prokuranepal/vtol/README.md

# VTOL
<a href="https://prokuranepal.github.io/vtol"> Docs Link</a>
