prokuranepal/vtol/docs/html/_images/3dprinted.png

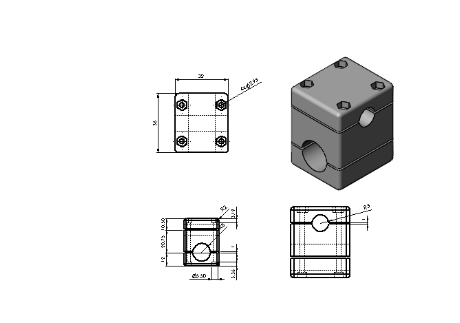
docs/html/_images/3dprinted.png
