prokuranepal/vtol/docs/html/_images/analysis2.png

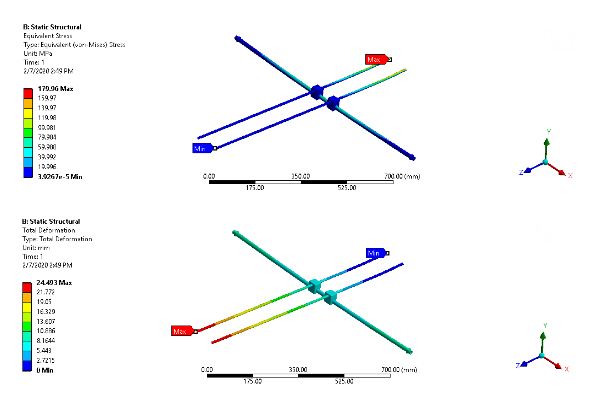
docs/html/_images/analysis2.png
