prokuranepal/vtol/docs/html/_images/flowchart.png

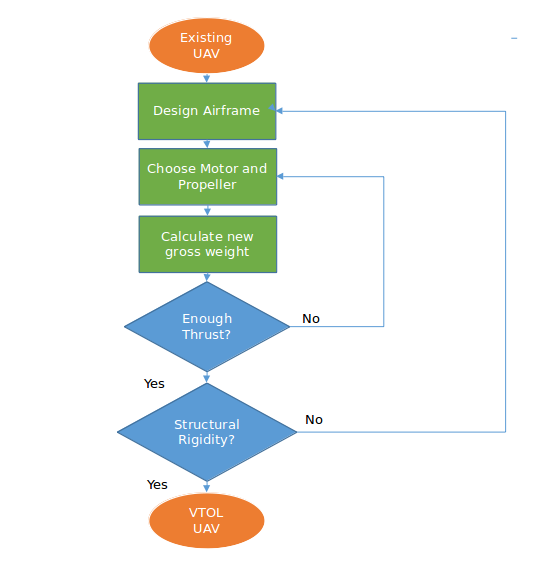
docs/html/_images/flowchart.png
