prokuranepal/vtol/docs/html/_images/graph.png

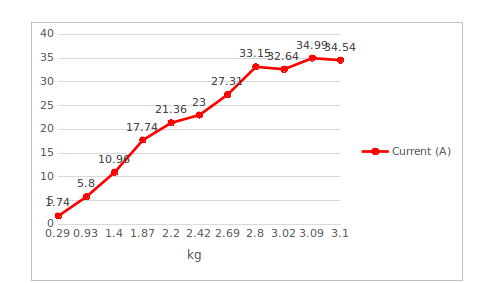
docs/html/_images/graph.png
