prokuranepal/vtol/docs/html/_images/vtol_image.png

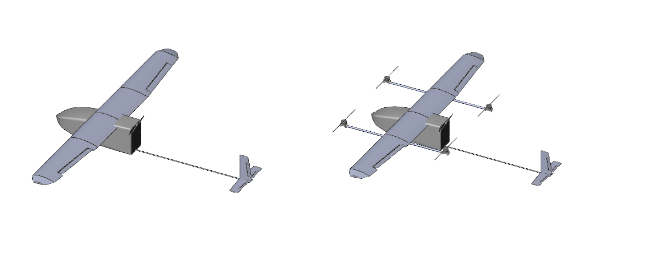
docs/html/_images/vtol_image.png
