prokuranepal/vtol/version2.SLDASM

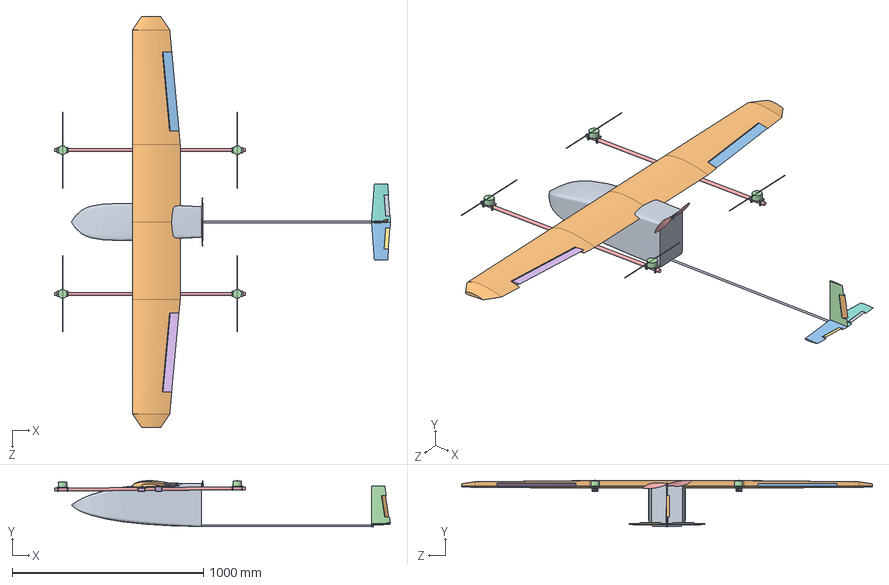
[picture p12: CAD file, 2020-02-07]
version2.SLDASM
1758.7 x 243.7 x 2150.0 mm
fuselage with boom
wing
horizontal tail
vertical tail
10x4.7-counterclockwise-propeller
aileron Port side
elevator port side
Mirrorhorizontal tail
Mirrorhorizontal tail - Copy
rudder
ailron s
boom anchor 2 x 4
quad boom x 2
anchor_wing x 4
