prokuranepal/vtol/boom anchor 2.SLDPRT

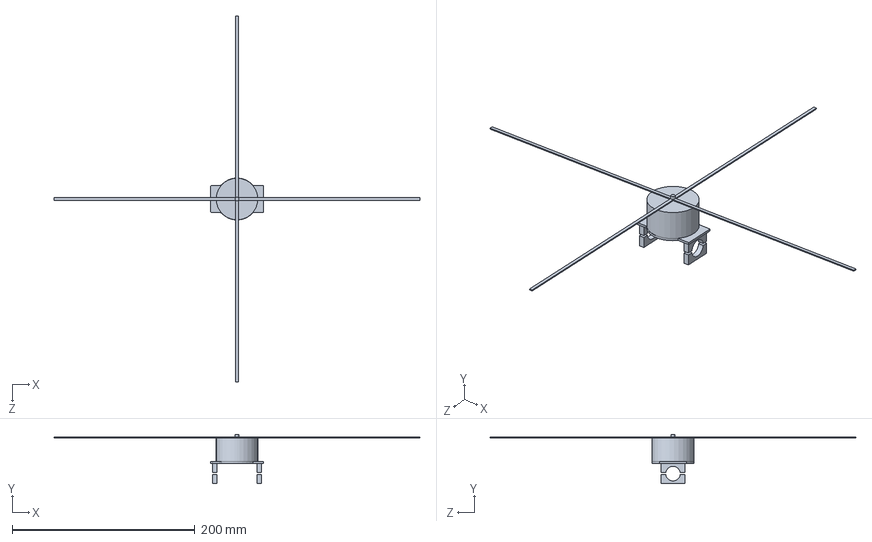
[picture p13: CAD file, 2020-02-07]
boom anchor 2.SLDPRT
400.0 x 54.0 x 400.0 mm
