prokuranepal/vtol/elevator port side.SLDPRT

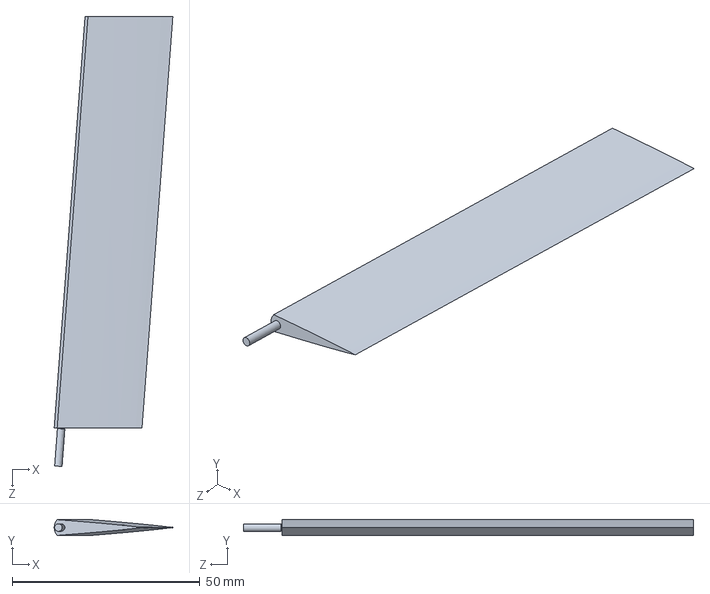
[picture p14: CAD file, 2020-02-07]
elevator port side.SLDPRT
31.7 x 4.34 x 119.9 mm
