prokuranepal/vtol/10x4.7-counterclockwise-propeller.SLDPRT

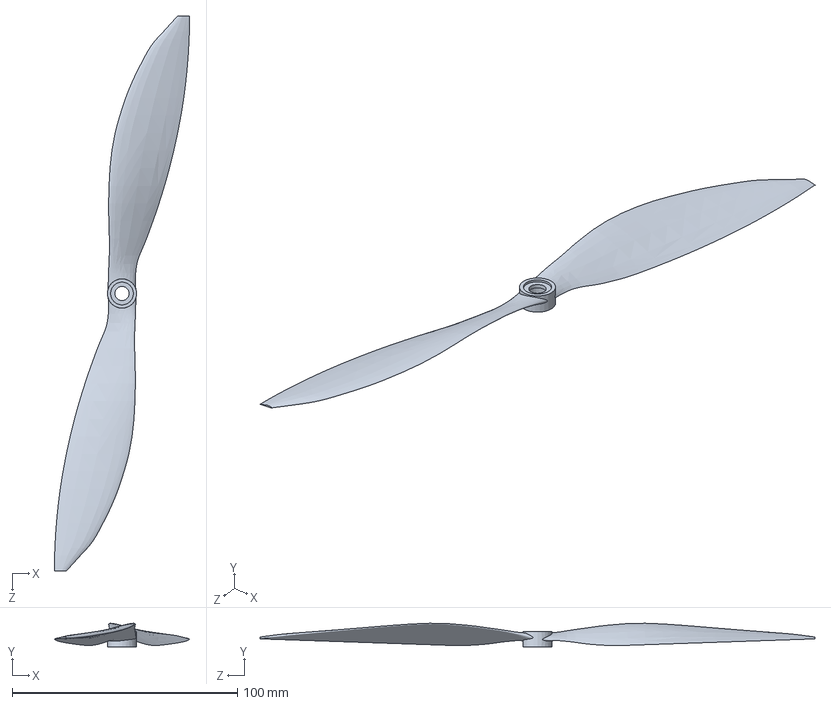
[picture p15: CAD file, 2020-02-07]
10x4.7-counterclockwise-propeller.SLDPRT
60.0 x 10.5 x 246.4 mm
