prokuranepal/vtol/horizontal tail.SLDPRT

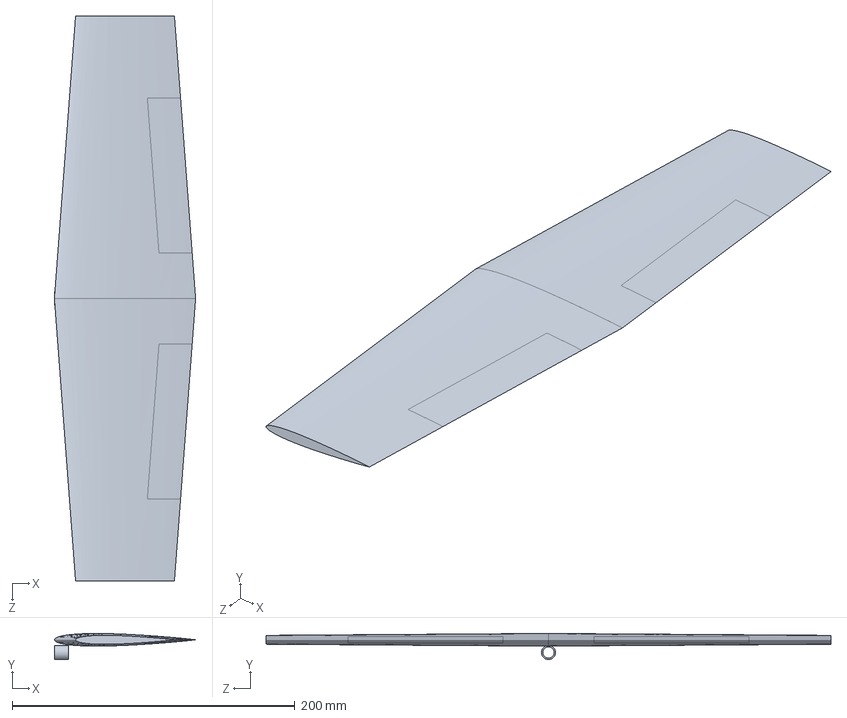
[picture p16: CAD file, 2020-02-07]
horizontal tail.SLDPRT
100.0 x 18.5 x 400.0 mm
