prokuranepal/vtol/aileron Port side.SLDPRT

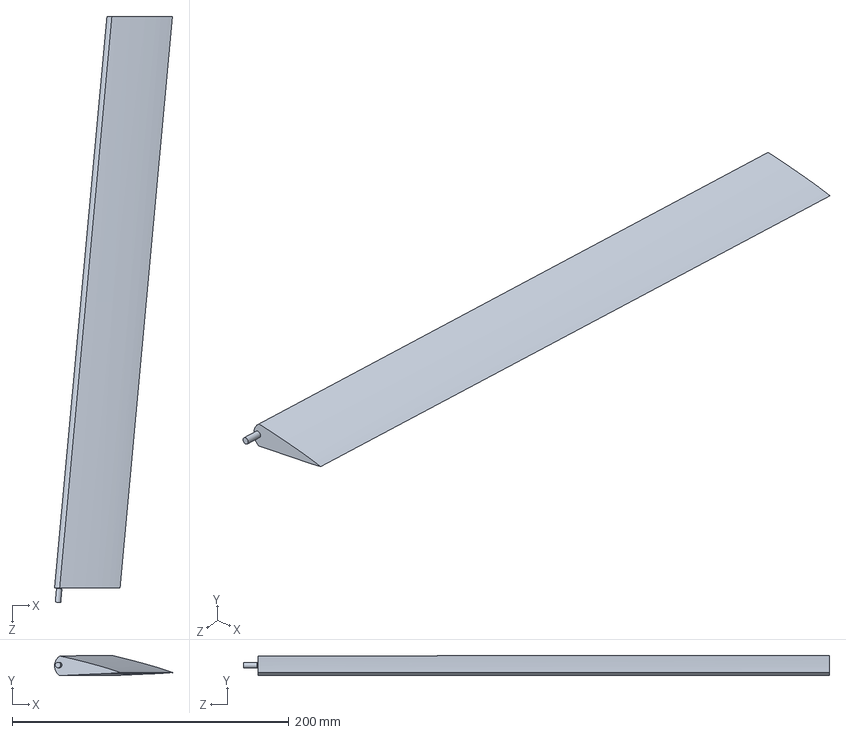
[picture p17: CAD file, 2020-02-07]
aileron Port side.SLDPRT
85.3 x 14.7 x 424.0 mm
