prokuranepal/vtol/wing.SLDPRT

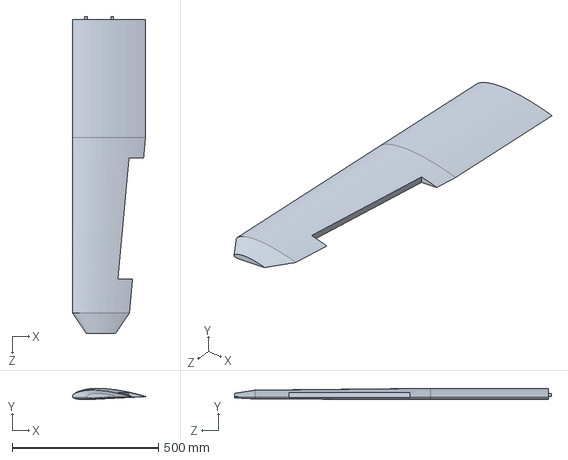
[picture p18: CAD file, 2020-02-07]
wing.SLDPRT
250.0 x 38.8 x 1085.0 mm
