prokuranepal/vtol/vertical tail.SLDPRT

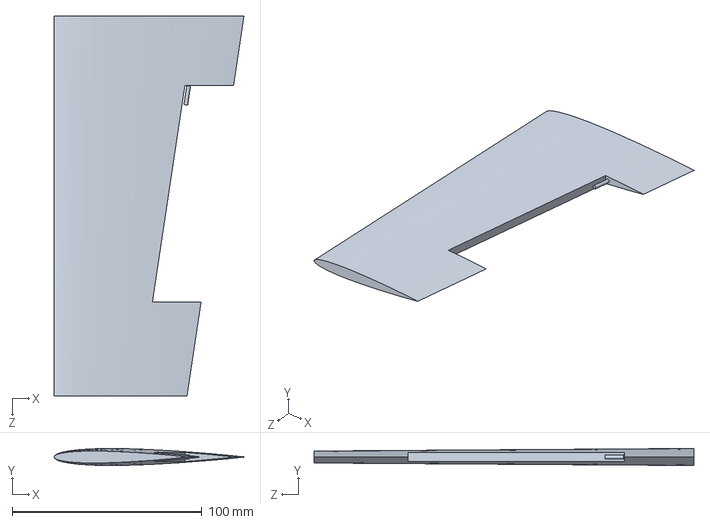
[picture p19: CAD file, 2020-02-07]
vertical tail.SLDPRT
100.0 x 9.01 x 200.0 mm
