prokuranepal/vtol/rudder.SLDPRT

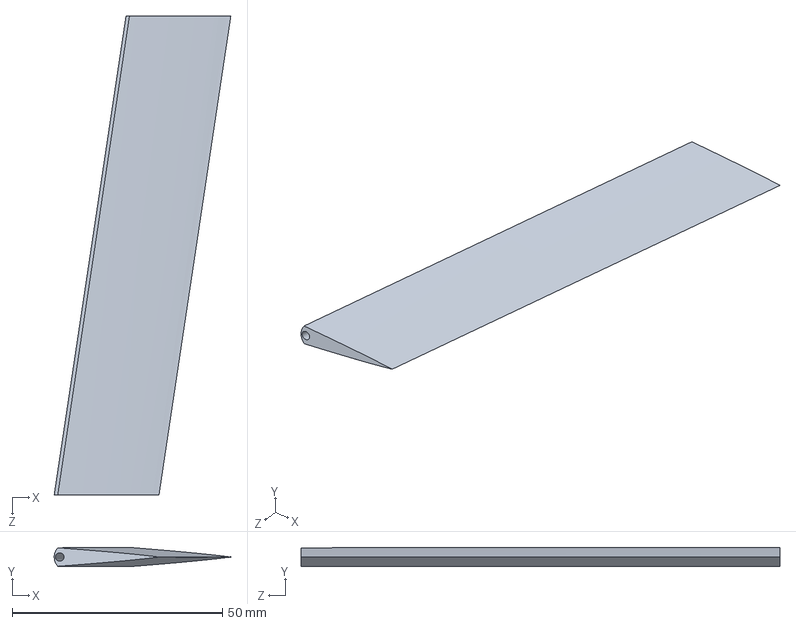
[picture p20: CAD file, 2020-02-07]
rudder.SLDPRT
42.0 x 4.56 x 113.9 mm
