prokuranepal/vtol/quad boom.SLDPRT

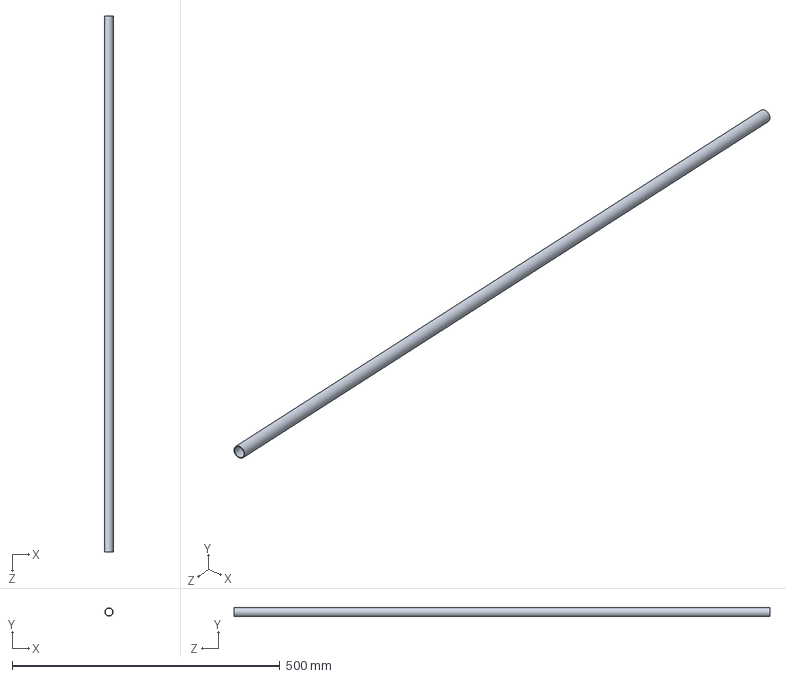
[picture p21: CAD file, 2020-02-07]
quad boom.SLDPRT
15.9 x 15.9 x 1000.0 mm
