prokuranepal/vtol/fuselage with boom.SLDPRT

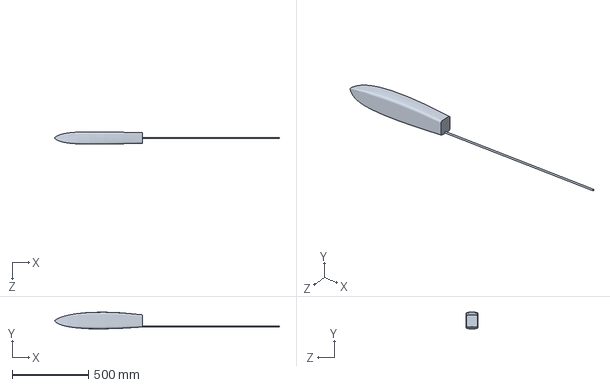
[picture p22: CAD file, 2020-02-07]
fuselage with boom.SLDPRT
1480.0 x 110.6 x 82.0 mm
