prokuranepal/vtol/ailron s.SLDPRT

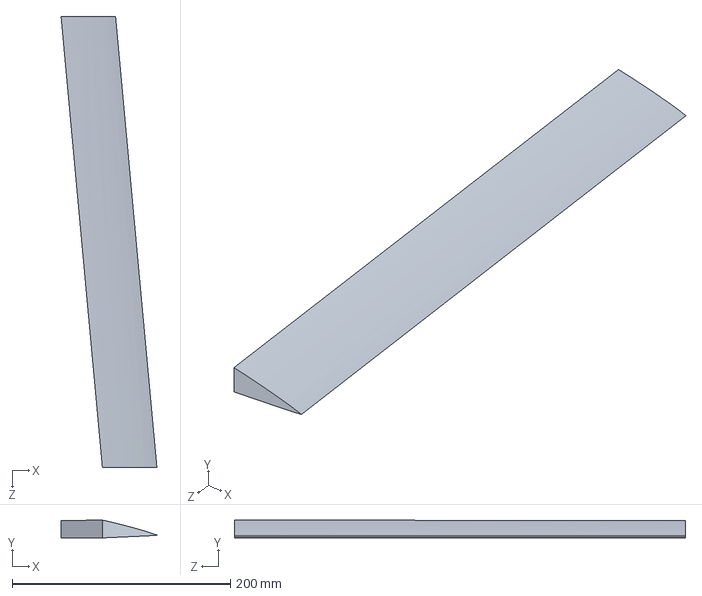
[picture p23: CAD file, 2020-02-07]
ailron s.SLDPRT
87.9 x 16.4 x 413.3 mm
