prokuranepal/vtol/anchor_wing.SLDPRT

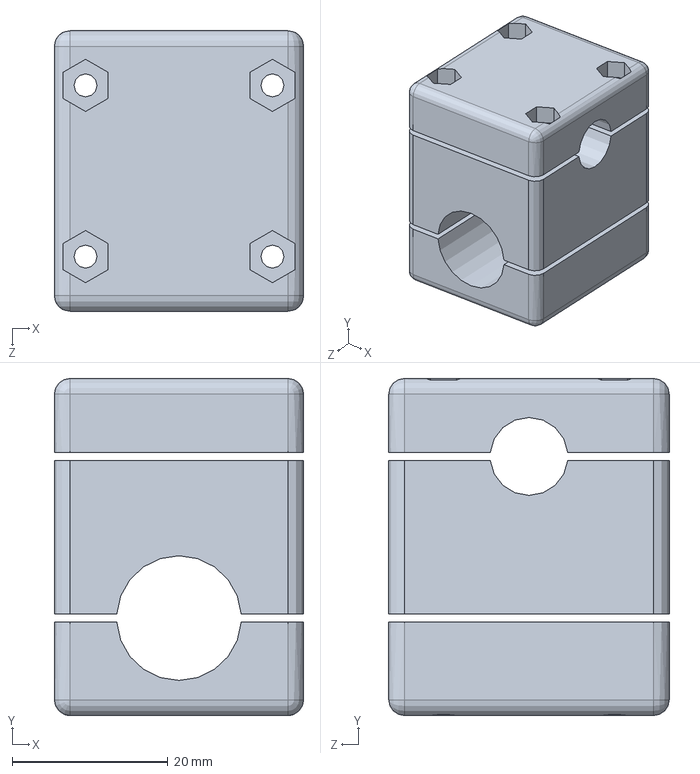
[picture p24: CAD file, 2020-02-07]
anchor_wing.SLDPRT
32.0 x 43.2 x 36.0 mm
