prokuranepal/vtol/(list of files, cad)

Other CAD files:
Mirrorhorizontal tail.SLDPRT
Mirrorhorizontal tail - Copy.SLDPRT
